amigabill/jhu_EN525.743/Docs/525.743_CDR_BillToner.odt

Critical Design Review (CDR)

Project Description

This project will design and implement a Smarthome lighting and ceiling fan control system. Controls will allow light fixtures to vary their brightness in a dimmable fashion, and ceiling fans driven by single-phase AC induction motors will be speed controllable.

Control messages will be sent wirelessly. The wireless communication will be using the Zigbee Mesh protocol. Xbee Series 2 modules will be used, in API mode and with built-in encryption capability enabled.

Wall “switch” controls will be small LCD touchscreens, communicating with the items they control via wireless command messaging. The LCD will allow the user to select a room, and then which target item in that room to view current status of, or to change it's state. (ie. The selected item in the selected room will get brighter, dimmer, slower, faster, etc.)

The target items being controlled will use a microcontroller as the Zigbee command receiver. Dimmable light fixtures or speed-controllable motor-driven target items will use a common Triac-based circuit to control the target as desired by the user.

A central computer server will log events, control “vacation mode” away events, and act as a gateway for automatic and manual controls sent from distant control devices carried by the home residents. This server will also act as the Zigbee wireless network “coordinator” node, in charge of the Zigbee mesh network. This server will also have an LCD touchscreen panel for

Android smartphones will offer both automatic and manual controls sent via the Linux server, and also a way to remotely view the server's log data in text form. Current status of the home targets will be visible in a GUI which mimics that seen on the LCD touchscreen wall “switches”. The mobile devices will primarily use a GPS based geofence to indicate whether the user is home or away. An alternative control method will be with the use of NFC tags at the front door of the home, so the user can manually swipe his or her mobile device across a tag to manually indicate that they are leaving or returning home. These two control capabilities allow the server to automatically enter and leave an automated, quasi-random “vacation mode”, where it will turn lights on and off at reasonable times to emulate the residents being home for added security from burglars.

This project will also be designed to allow future expansion, with possibility to add new kinds of target items to control and new types of controls. The intention is to complete a project comparable to popular X-10 systems, but which will send control commands wirelessly instead of signaling over power line. Some example ideas for future additions are garage doors, electronic entry door locks, thermostat HVAC environment control, or safety shutoff for electrics ovens or lab soldering stations, in case you forget to turn them off when you leave home, but these examples are not included in this semester's project effort.

While the ideal would be for the wall “switch” controls to fit into a standard Decora ™ wall-plate and housing gang area, and target controls would fit into common ceiling fan wiring canopies or other light fixture wiring boxes, this project during the semester will be made using prototyping computing and interface boards, which will not cleanly fit such common switch housing, and so will not implement a cosmetic ideal. To cosmetically fit into the popular housings would require custom PCB design and assembly to compact the various components used, as well as alternate choice of LCD touch panel of proper size, which may not be supported by the intended Arduino code libraries available, and require software porting to make use of. These additional tasks are beyond the scope of this semester's effort to create a working prototype.

This project evolved from an initial concept of a wireless controlled light switch, and complexity was added to bring that up to an acceptably complex project for this course.

This project is an individual effort, and does not depend on other projects, nor do other projects depend on this.

Functional Description

Diagram 1 shows the three types of user control units: 1) The wall-mounted LCD touchscreen controls, located in the building as any other type of light switch would be, and likely replacing older model switches as this system is installed, 2) The central Linux server and coordinator panel, which could be wall mounted or in an enclosure resting on a desk or table, and 3) The Android mobile device App. The possible communication participants are indicated with blue arrows to show a Zigbee connection, or green arrows to show an Internet connection.

Diagram 1:

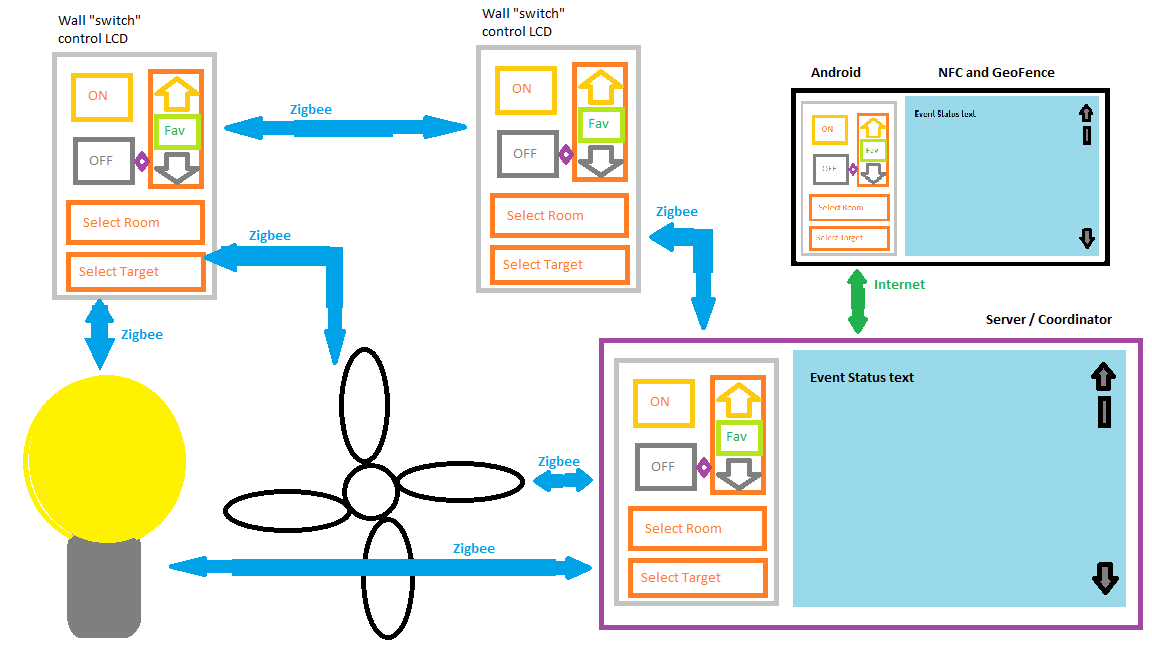
[picture p1: figure]

At boot time, any Arduino based node (either Uno or Due), will first check if a hardware push-button is asserted, to indicate that the user wants to use a PC on the board's USB port to configure the Xbee module, using the XCTU utility software. If asserted, then the Arduino board will enter a non-active microcontroller state to avoid contention on the USB pins. Otherwise, the board will continue to boot into operational mode.

An Arduino target node (controlling some load such as a light fixture or a ceiling fan, and potentially more than one load) will look to stored values in EEPROM or Flash to determine the last running intensity value for the load. Each load will then be set to be at that last saved intensity value. This will allow a quick recovery from a power outage, without a delay of waiting for the Linux server to boot, all the other Arduino nodes to boot, and receive, load ID by load ID, setting commands from the server based on the most recent settings found in the event log.

Once the last saved intensity value is restored to each load, then the target node microcontroller will begin listening for command messages from the Zigbee network.

A wall control Arduino node will proceed from the Xbee config check to gather information about controllable load units, which target nodes they are controlled by, room locations of loads, and what the “default” load ID and location are assigned to it.

Then, the wall control will begin polling the load IDs to learn their current intensity level or other status value.

The wall control then updates the LCD display to indicate the default load ID, location, and current intensity setting.

After the LCD is displaying the current situation for it's default load, the wall control unit will then begin listening for commands from the Zigbee network as well as from the touchscreen and any debug controls.

When a manual, debug or Zigbee control is received, any Zigbee node will carry out the messaging conversation as defined for that command type, and when completed will return to a state of waiting for another control input or message.

The Linux server will boot up, prepare Zigbee networking, prepare Internet networking, open the even log file for appending, read last known status for each node from event log, check what other nodes are expected to exist and check they are all booted and available with a Read Intensity command via Zigbee, note any nodes not responding, log any updated current values from the target nodes if not matching the last known value in the event log, determine the default load to display on the LCD and to control, configure the LCD display to show the now current intensity level for the default load ID, read and then display the event log text data. Then begin listening for Zigbee commands, listening for commands from the Internet, as well as waiting for touchscreen inputs.

The Android app will determine the related default load ID, prepare Internet networking, and attempt to connect to the Linux server via Internet.

If not successful in connecting to Linux Server, then draw to LCD an indication that connection is not available. Continue attempting connection periodically.

When successfully connected to Linux server, then get the now current states for target nodes, get the current event log content, draw the control panel indicating the current level for the default load as well as the default portion of the event log text data. Then wait for Android touchscreen input from user, and also periodically update node states and event log data from server.

If server becomes disconnected, then display an indication to LCD.

If server becomes reconnected, then update the indication to LCD.

Protocol

This system will use a Zigbee wireless method to communicate with other nodes. The message content will be encrypted by the Xbee module firmware, so our software will not need to include an encryption library.

The communication protocol will be a command made in 4 steps:

1. Sender sends command to recipient
2. Recipient Acknowledges command received, asks sender for confirmation
3. Sender sends confirmation
4. Recipient indicates completion success or failure

Diagram 2 shows the Arduino and shield configuration for an LCD touchscreen wall control node.

Diagram 2:

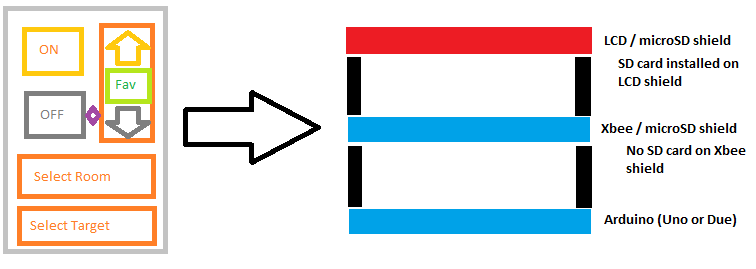
[picture p2: figure]

Diagram 3 shows the Arduino and shield configuration for a target node. This is identical for a light controlling node, a ceiling fan controlling node, and possibly some other node types which could be added in the future. One target node can actually control two, or possibly a few more than that, loads, so that one unit can control both a light and a fan.

Diagram 3:

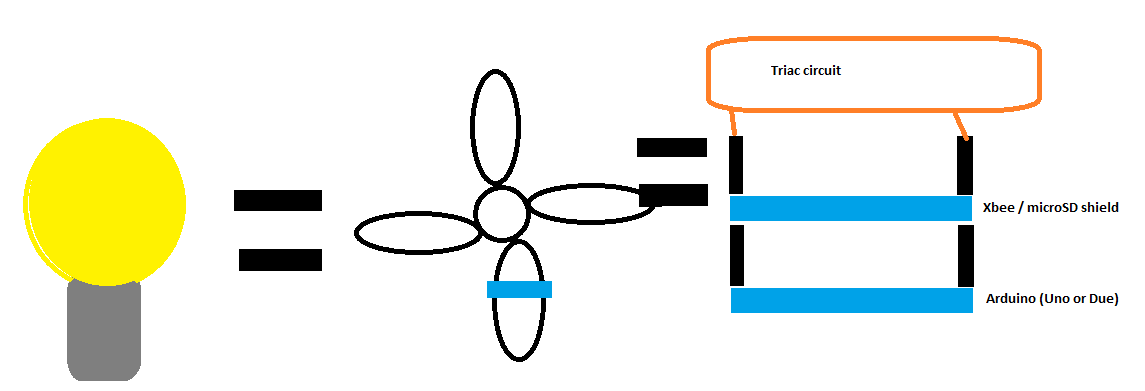
[picture p3: figure]

Interface Description

The most commonly used interface will be a small LCD touchscreen, mounted about the home (or business) in wall-switch wall-plate locations.

The LCD will display

- A Graphical User Interface to select the room and target device location, view current target state (as the target may be located in another room and not directly visible)
- Control buttons to increase or decrease target brightness or speed, full on or off, or some favorite intensity level for that target. An indicator will move up and down in a small track to indicate the currently set intensity.

The Linux Server and the Android app will display the same control panel as described in Diagram 1 for the wall controls, but adds visibility of the event logging data as well. This keeps things consistent and familiar, so that the user only needs to learn to use one control interface arrangement. It would be confusing and irritating if each control type looked significantly different from the others. The only variance will be the omission of event log visibility on the small wall switch controls.

Diagram 4 shows the pin mapping of the two types of Arduino microcontroller boards and the different “shield” boards I plan to connect to the Arduinos. This diagram shows that the LCD touchscreen wall “switch” nodes have a conflict on pin 4 between the LCD shield and the Wireless/SD shield. This is not a significant problem, as for these nodes, I will instead use the SD slot located on the LCD shield to avoid any conflicts. Target nodes will not include the LCD shield, and so there is no conflict on pin 4.

Diagram 4:

Table 1 describes the additionally required signals in and out of the Arduino units, which are required to interface to the 120V AC loads and to debug pushbuttons and LED indicators.

Table 1:

Description of Misc and Triac Signals
Signal Name | Description
Xbee config (also btn fn/lt sel??) | Active-Low – When asserted at boot time, Arduino goes into a dummy loop or does an exit, so that USB can be used to the Wireless/SD shield's Xbee module for configuration using XCTU software on a PC. Otherwise has no function. (might optimize to share this input with btn fn/lt sel, which is only effective in run-time)
Xbee config status | When lit, indicates that the Arduino board is in an inactive state so that a PC computer can communicate with Xbee module over USB for configuration, usign XCTU utility software.
btn fn/lt sel | When High (default by pullup), tells Arduino to apply any other manual button inputs to the Light control. When Low, tells Arduino to apply any other manual button inputs to the Fan control. (Also used on wall control node development to test communication and control of target, before adding LCD touch shield support. Once LCD shield is added, this button must be removed from wall control.)
btn On/Off | Active-Low – When asserted, change the target power applied state. Like a “bang-bang” power enable control. (Also used on wall control node development to test communication and control of target, before adding LCD touch shield support. Once LCD shield is added, this button must be removed from wall control.)
btn Up | Active-Low – When asserted, increase intensity (brighter/faster) to target. (Also used on wall control node development to test communication and control of target, before adding LCD touch shield support. Once LCD shield is added, this button must be removed from wall control.)
btn Down | Active-Low – When asserted, decrease (dimmer/slower) to target. (Also used on wall control node development to test communication and control of target, before adding LCD touch shield support. Once LCD shield is added, this button must be removed from wall control.)
PWM Light | Pulse-Width Modulated control of triac circuit for the Light target
PWM FAN | Pulse-Width Modulated control of triac circuit for the Fan target
AC 0-cross | Active-High - Input pulse to indicate the 120V AC line waveform has crossed the 0V line, and a new waveform period begins.

Zigbee message format

Each Zigbee message will have a twelve byte logical payload, as described below. The “physical” payload, in the Zigbee total frame, may be a few bytes larger, as I understand that the Xbee firmware encryption feature requires this to be done.

Each node will have one or more 16bit ID values, which will be the first two bytes in the Zigbee message payload. The first byte in the payload is the ID MSByte, and the second byte is the ID LSByte. Each node can potentially have more than one target load ID, such as a node that controls both a light and a fan motor. One load ID will relate to the light, and another load ID will relate to the fan. So there are multiple kinds of IDs that will be included in the total Zigbee frame, the Zigbee address ID, which is not part of the payload, and the target load ID, which is part of the payload. While a 16bit value may sound excessive to ID a particular load, consider that a commercial building could potentially consume more than the 256 ID values, if I had chosen a single byte ID. An individual home would not likely consume 256 IDs, even if every outlet, light switch and light bulb in the house was uniquely addressable. But I'd like this to have potential beyond the home market, and make it appealing to businesses as well.

The third and fourth bytes will be the MSByte and the LSByte, respectively, of the node sending the command. This will tell the recipient where to send response stages of a full command conversation.

The fifth byte in the payload indicates the current message type within a single multi-message communication. Such as this indicates the initial command request, or the acknowledgment/confirmation request, or the confirmation, or the command completion and status notice.

The sixth byte in the Zigbee message payload will be a command code. There will be several commands that can be made to the recipient. They will be encoded as a byte value for convenience in the case of Arduino Uno, which is an 8bit microcontroller with small memory resources. To help keep the stack and code compact, I will not choose to subdivide a byte into multiple different fields and then add code to mask and shift these fields around. This command code should remain fixed through all message stages of a single command communication.

Command | 8bit Encoding | Description
No Operation (nop) | 0x00 | Tell recipient to acknowledge and complete this communication, but otherwise do nothing.
On | 0x01 | Tell target to power on the load
Off | 0x02 | Tell target to power off the load
Increase Intensity | 0x03 | Set load to be one step brighter/faster
Decrease Intensity | 0x04 | Make light one step dimmer/slower
Set to Favorite level | 0x05 | Set target load to stored favorite level
Store current level as Favorite | 0x06 | Save current intensity level as Favorite
Read Favorite level | 0x07 | Ask target to say what the stored Favorite intensity level is
Read current level | 0x08 | Ask target to say what the current intensity level is
Event Notice | 0xFF | Inform the Linux server that a command event has been completed, and what the new status is, for log purposes. Inform the server what the command was, what the target load ID was, and the status value.

The seventh and eighth bytes will be the MSByte and LSByte, respectively, for any message passing a status value, a Favorite or current level read response, or event update notice.

The ninth byte will be the status value or the intensity level value asked for.

The tenth byte will be a CRC check on the first seven bytes of the payload.

The eleventh and twelfth bytes are reserved for future use.

Material/Resource Requirements

There are no dependencies from other projects. This project does not provide any dependencies to other projects. It is a completely independent effort.

This project is an individual effort. So there is no particular assignment of certain tasks between multiple team members, all project tasks are assigned to this single individual, Bill Toner.

There are three major components of the smarthome system. There are also some general household items, such as light fixtures, ceiling fan units, wiring boxes and power cabling which will be required.

Both the controls and the targets in the Arduino class will require an Arduino microcontroller board and the Wireless/SD shield, which holds an Xbee module and possibly a microSD card. The controls will also require an LCD touchscreen/SD shield, and the targets will also require the triac based AC line control circuitry. The target end will also require a couple lights and a ceiling fan to control. An Xbee module will be required for each Arduino and target node. A 2.4inch LCD touchscreen+SD module was chosen so that these prototypes are close to a standard Lenovo Decora™ wall-plate slot. A commercial product would need to refine into a more exact LCD package.

I have not yet purchased components for the triac AC line control circuits, as I will need more time to evaluate available app notes and examples to determine appropriate part numbers to use in this design. I will do this during the weeks leading up to my scheduled time to work on this part of the system, leaving a week or so for shipment and delivery. If delivery is for some reason delayed a little, then I will begin assembly of the Fan and light fixtures with some wiring and electronics enclosures in preparation of the triac circuits coming, and then begin work on the Android app until the AC control components are received.

I already have a couple Arduino Uno boards, have ordered one each of a few items for fast delivery, and ordered additional copies of some items at lower cost with slower delivery. I have now received Wireless+SD shield and LCD touch/SD shield. I also have ordered a few Arduino Due boards, and already have one in possession. Additional Unos and Dues are in shipment from Ebay sellers located in China. I have already received some items from Chinese sellers, and anticipate the remainder of my orders arriving by the end of the first week in October, 2015.

The Linux server will be built using an AMD Gizmo embedded computing board, a 7 inch LCD touchscreen, a USB WiFi dongle, an Msata storage card, and some custom connectivity to the Xbee module. I already have the Gizmo kit. I had purchased a Gizmo kit a few months ago in order to get an AMD jtag probe for unrelated personal interest. I will likely need to do some bread-boarding

For the Android class, I will be using the smartphones that My wife and I already own and use. I will also use a home Wifi network router that I already own as the backbone of my simulated internet between the Android devices and the Linux server.

I have acquired a couple simple, inexpensive light fixtures, wall electrical boxes, and an inexpensive ceiling fan unit, to act as my targets to be controlled by this system. If this fan unit, the least expensive one I could find amongst my local hardware stores, proves unsuitable, I do have another ceiling fan unit of higher quality pending a small home improvement project, which could be used as a backup in this project. I don't expect this to be necessary as there are several online examples and app notes in general agreement for how to use triacs to control ceiling fan motors. While a few discussions indicate that a capacitor and/or frequency based speed control circuit may be more ideal, I have not found any app notes or examples for this approach, but I will keep it in mind as an alternative should I have significant problems with the triac design. I will initially focus on the triac concept due to apparent popularity.

I plan to assemble the triac circuit I will use in an Ltspice simulation. Then, once satisfied with function and performance, I will use a suitable oscilloscope to observe the AC waveform applied to the initial test load, by a prototype hardware setup with an inexpensive incandescent light bulb. This will start out as an Arduino Uno being hard-coded for speed and/or being controlled by a PC laptop. I also have a commercial wired style light dim and fan speed control pending a home improvement project, which I can observe with a scope to learn behavior if I have problems with triac and need some ideas.

Table 2 shows various components required, how many of each, and the price. An estimated total cost is then shown as a sum of these items. The software development environments and the Linux operating system are all available free of charge, and without an expiration date.

Table 2:

Component | Needed | Already Have | Price Each | Total | Description
Arduino Uno | 3 | 3 | $3.67 | $11 | Microcontroller in direct control of target load units. Cheap clones from Ebay.
LCD Touchscreen/SD shield | 3 | 0 | $4.60 | $13.80 | For wall “switch” control nodes.
Arduino Due | 3 | 0 | $15.39 | $46.17 | Microcontroller for wall “switch” LCD touchscreen controls
Wireless/SD shield | 6 | 0 | | | For ALL Arduino nodes
2GB microSD cards | 6 | 0 | $2 | $12 | “Mass” storage for graphics, system node configuration, room locations, etc.
AMD Gizmo embedded computing board | 1 | 2 | $200 | | Linux server
Light fixture | 2 | 0 | $5 | $10 | Simple and cheap
Ceiling Fan | 1 | 0 | $32 | $32 | Cheapest at local store
Android mobile device | 2 | 2 | | | My wife and I already have Android smartphones. One supports NFC feature, the other does not. Both support GPS and Internet data networking.
Zigbee module in Xbee format | 7 | 0 | $26 | $182 | Wireless networking module for Arduinos etc.
Total | | | | $307 | approximate

Development Plan

The source code, circuit diagrams, documentation, and any other digital data related to this project will be committed and tracked using a Design Management (or Configuration Management in some vocabularies) repository using the GitHub service, located at the link below. This is set as a private repository, and I'll add professor and class members who may be interested, on request, and once I figure out how to do that.

https://github.com/amigabill/jhu_EN525.743

I plan to work on the various system components in the following order:

1. Arduino
- SD card storage (contains some node configuration data)
- Zigbee communication (With PC laptop as coordinator at this point)
- Target control of AC line triacs (with at least some visible output indication, such as a small LED, in place of final triac circuit)
- Touchscreen input events, using some pre-planned location for test “buttons”
- LCD GUI implementation
- Anticipating the possibility that the available libraries I plan to use may not all fit together into an Arduino Uno memory space, I plan to use Due boards for the LCD touch control nodes. Uno's are likely to be suitable for the target nodes, as those do not require LCD graphics related libraries or touch drivers, and will have a smaller memory footprint.
2. Linux Server (AMD Gizmo embedded project board)
- Zigbee coordinator
- Communicate with targets
- Communicate with wall touchscreens
- Implement event logging
- GUI using WxWidgets library
- Networking with internet, using a home WiFi router to emulate the internet. (Overlaps with Android App communicating with Linux server)
3. Android smartphone app
- Communicate with Linux Server
- GUI indication of targets current states
- GUI manual control of targets
- NFC tag manual location indications (easier to demo than Geofence)
- GPS Geofence locations (somewhat harder to demo than NFC)

The anticipated schedule is shown in Table 3.

Table 3:

There are 5 major milestones.

1. Arduino Uno target controller
2. Arduino Due wall-plate LCD touchscreen controller
3. Linux Server/Coordinator
4. AC line load controller circuit, which is controlled by #1 above.
5. Android Smartphone Application

It's important to start with the Arduino targets and controls, as without them there is nothing for a Linux server or Android app to do. The next major priority is the Linux based server, to coordinate the other Zigbee nodes, observe and control target events, etc. This server along with the Arduino nodes then make up the bulk of this project's core functionality. Once the server is complete, then I will implement the triac circuitry to control the AC line to a real target light or fan motor in place of the earlier placeholder status LED. At this point, within the home is a fully functioning system with “real” targets working. Finally, I will move on to implementing the Android app. Should scheduling slip, the Android app is not as critical as the Arduino nodes or Linux server roles in this project, and so if anything should not get completed, this app is the most reasonable choice to be worked on last.

Some modifications may be required to the shields to improve signal quality on Arduino pins used on both modules, such as D4 which is SD_CS on the Xbee/SD shield, and an LCD data pin on the LCD shield. Cutting the D4 and other SD slot traces on the Xbee/SD shield, and not using SD on the Xbee/SD shield can help. The LCD shield has another microSD slot on it, using D10 for SD_CS instead of D4.

There are some risks in this schedule.

- I have not worked with Arduino or AVR microcontrollers before. During my previous experience with Atmel Sam-4 ARM devices, I worked some with SD protocol, in both C and Verilog, which would be beneficial to this project. I also worked with other peripherals such as Usart and Duart, parallel ports, interrupts, and I also had experience programming the Rabbit3000 and Xilinx Microblaze in prior courses at Johns Hopkins University, to show that I can move to different library APIs/ABIs in an acceptable time-frame for comparably complex projects.
- I have not worked with wxWidgets for a GUI application in Linux before. There are Rapid Application Development tools available, which I will make use of to assist in building the general code framework and creating the GUI interface. There is a thriving online support community for wxWidgets, and I have been looking at the API a little while pondering an unrelated project to port the wxWidgets framework to an operating system it is not currently available for, so I'm not going into that with a completely clean slate.
- I have a small amount of experience with internet networking, such as the communication between Android app and Linux server. This experience is from the JHU course EN.525.742 System on Chip FPGA Design Lab, which I took a couple years ago. There I learned about ethernet message packets using Xilinx Microblaze microcontroller and a minimal library to hit the hardware, and the use of WireShark for debugging packets coming out of the FPGA board. I will be sending simpler messages in this project.
- How to demo geofence within range of WiFi router in the classroom? I will see if I can bribe my wife into being a remote participant during demo night, using her Android device over cell data network communicating with the Linux server via the WiFi hotspot in my own Android device, which will act as my in-classroom “home internet router” for the Linux server.
- I have not programmed in Java before. I plan to use a Rapid Application Development tool to assist with general code framework and creating the GUI interface. From there, I will have to be able to take a general pseudo code of my intended application and quickly learn the Java syntax to accomplish that design. Online Java examples abound, and there are several online support communities available when I have a question.
- During week 5, after the PDR presentation, my supervisor at work has asked me to attend a week-long training seminar in the month of November, along with everyone else in the group under him. It will be difficult to keep up with my normal work, the training, evening group meetings and other activities, and also continue a good pace on this project. I have requested permission to take a few days vacation to focus on this project to compensate, and also described the situation regarding this course and scheduling, and await a reply to this request. I rarely take time off work, I now have a second person assisting in my role, and my overlords have a history of being very supportive of the time off requests that I have made in the past, so I do not anticipate that this training event will have a significant impact on this project schedule.

References

The programming environments, operating systems, and support libraries that I plan to use are all available at no cost. There are no expensive licenses to buy or to expire at an inconvenient time.

Programming IDEs, SDKs, and Frameworks:

- Arduino - https://www.arduino.cc/en/Main/Software
- Android Studio/SDK for Java - https://developer.android.com/sdk/index.html
- Android NDK for C/C++ - https://developer.android.com/ndk/index.html
- Linux for AMD Gizmo board - http://www.timesys.com/register/gizmo
- wxWidgets (for Linux GUI in C++) - http://wxwidgets.org/

I plan to make use of available libraries as much as possible for various components of the software.

Arduino Libraries:

- Arduino SD library - https://www.arduino.cc/en/Reference/SD
- Arduino TFT Library for LCD panel driver, or relevant equivalent for the LCD controller used - https://www.arduino.cc/en/Reference/TFTLibrary
- Yamsam LCD https://github.com/yamsam/TFTLCD_ST7781

Arduino Shield documentation:

- Xbee+microSD - https://www.arduino.cc/en/Main/ArduinoWirelessShield
- LCD touch+microSD
- http://www.smokeandwires.co.nz/blog/a-2-4-tft-touchscreen-shield-for-arduino/ (for same LCD controller info and library)
- https://github.com/yamsam/TFTLCD_ST7781
- SmokeandWires LCD http://www.smokeandwires.co.nz/blog/a-2-4-tft-touchscreen-shield-for-arduino/
- Adafruit Graphics Core library - https://learn.adafruit.com/adafruit-gfx-graphics-library/overview

Digi Xbee

- http://ftp1.digi.com/support/documentation/90000976_W.pdf
- http://knowledge.digi.com/articles/Knowledge_Base_Article/What-is-API-Application-Programming-Interface-Mode-and-how-does-it-work
- https://github.com/andrewrapp/xbee-arduino
- http://ftp1.digi.com/support/utilities/digi_apiframes2.htm
- http://arduino.stackexchange.com/questions/1500/how-to-make-xbee-module-interrupt-wake-arduino

(http://wxwidgets.org/)

Ltspice

- http://electronicdesign.com/power/model-diacs-and-triacs-ac-line-control
- http://electronics.stackexchange.com/questions/87546/ltspice-mac97a8-triac-model-vgs-error

There are several online app notes and example designs which will be relevant to this project:

- Atmel AVR datasheet (Arduino Uno) - http://www.atmel.com/Images/doc8161.pdf
- Atmel SAM3 Cortex-M3 datasheet (Arduino Due) - http://www.atmel.com/Images/Atmel-11057-32-bit-Cortex-M3-Microcontroller-SAM3X-SAM3A_Datasheet.pdf
- Triac AC line control:
- Microcontrollers: From Assembly Language to C Using the PIC24 Family http://www.freescale.com/files/microcontrollers/doc/ref_manual/DRM039.pdf
- http://cache.freescale.com/files/microcontrollers/doc/app_note/AN3471.pdf
- http://www.st.com/web/en/resource/technical/document/application_note/CD00003820.pdf
- http://ww1.microchip.com/downloads/en/AppNotes/91094A.pdf
- http://www.mouser.com/catalog/specsheets/stevalill004v1.pdf
- https://books.google.com/books?id=ndALAAAAQBAJ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

LCD touchscreen for Linux Server

- http://www.sainsmart.com/7-inch-tft-lcd-monitor-for-raspberry-pi-touch-screen-driver-board-hdmi-vga-2av.html

525.743 Fall 2015 Critical Design Review (CDR) Johns Hopkins University Bill Toner Smarthome Lighting and Fan Control
