amigabill/jhu_EN525.743/Docs/ZigbeeNotes.odt

All radios in same network must have same PAN ID set.

AT Mode

- Needs DH and DL set to assign the destination radio, using atdh and atdl commands
- Broadcast destination address, in DH and DL settings, 0x00000000, 0x0000ffff is broadcast to all radios in same PAN ID
- Specific destination address, in DH and DL settings, goes only to that one receiver.

API Mode

- Does NOT need DH and DL set to assign destination radio. This is done within the API frame.
- Broadcast destination address, in the API frame, 0x00000000, 0x0000ffff is broadcast to all radios in same PAN ID
- Specific destination address, in the API frame, goes only to that one receiver.
- Data to send goes into uart TX buffer via Serial.write(), API frame type is 0x10
- Received data in uart RX buffer via Serial.read(), API frame type is 0x90 RX Received

Mixed API and AT modes

- An API mode module can talk to an AT mode module, and vice-versa
- The API or AT mode is how the thing on the serial port (microcontroller, PC etc) talks to the module.
- The choice between API and AT has no effect on how radios talk to other radios.

Sending data

- API frame type is 0x10, Transmit Request
- API mode sender puts full frame data into uart TX buffer, from delimiter to checksum, inclusive.
- AT mode sender puts ONLY the payload into uart TX buffer.
- It doesn't matter what mode the receiver isin.

Receiving data

- It doesn't matter what mode the sender was in.
- API receiver receives the full frame at uart RX buffer, from delimiter to checksum, inclusive.
- API frame type is 0x90, RX Received
- AT receiver receives ONLY the payload on the uart RX buffer.
