amigabill/jhu_EN525.743/Docs/pdr_wtoner_2015fall2_as_submitted.pptx

## Bill’s Automated Home System

Arduino, Linux and Android system for wireless control of home lighting and ceiling fans.

## Wireless Smarthome System

- Will use Xbee type Zigbee modules for wireless communications, in a Mesh configuration.
- Arduino prototyping boards for “wall switch” controls and target receivers. Arduinos will be Zigbee router endpoints.
- Linux based central “server” and Zigbee Coordinator. Coordinates Zigbee network, logs activity,, controls away/vacation events, provides control and status capability via internet.
- Android smartphone control. (I don’t’ have an Apple iDevice, but that could be some future addition)

## Zigbee wireless

- Mesh topology.
  - Central “Coordinator” running Linux, connected to an Xbee coordinator module
  - Using routers (as endpoints) in the Wireless topology helps to extend communication range if there are radio obstacles in some parts of the home, or if certain locations are at a long enough distance for weak signal at low broadcast power levels. Run by home AC mains, so no real worries about power consumption to require true endpoints.
  - Arduino controls use Xbee router node
  - Arduino target receivers use Xbee router node
  - Use Xbee modules in API messaging mode
  - Encryption for Security – Xbee’s APS mode or Arduino AES software library

## Controls

- LCD touchscreen “wall switch” – 2.4inch model is inexpensive for Arduino. Depending on code size, either Uno or Due microcontroller.
- LCD touchscreen server/coordinator. Logging and controls also accessible via internet/WiFi Android device. Programming/controls access via SSH to PC. Either an AMD Gizmo (I want to use it for something) or Raspberry Pi would make a decent central coordinator.
- Android Geofence (GPS location of family smartphones)
- Android manual control App
- Android NFC tags by front door as option to geofence

## Controllable Targets

- Light fixtures - Dimmable fixture – using a Triac based circuit
- Ceiling Fan - Single-Phase AC Induction Motor – also use Triac based circuit
- On/Off for simple light fixtures, outlet dongles, small appliances, etc.
For dim/speed control, detect a zero-crossing of the AC Line waveform, and then pulse the Triac for some percentage of the AC line waveform. Adjust the amount of the AC Waveform time the Triac is on to control dim/speed.

## LCD Touchscreen Controls

- Select Room
- Select Target (light, fan, desk lamp etc)
- Darker/slower
- Lighter/faster
- Store (in target?) current setting as favorite (to eeprom, flash or SD)
- Go to favorite level/speed (from whatever current state)
- Communicate to selected target
- Communicate to server for logging
- Receive from Server for other controls (smartphone or server panel) to update local target state changed by another control.
- Full on or off (also available in a simpler button or toggle switch control dedicated to a particular target set)

## Control Message via Zigbee

- Command, Acknowledge, Confirm, Completed. (master, slave)
- Network ID (not same as plaintext Zigbee ID)
- 16bit node ID (not same as plaintext Zigbee ID)
- Node type (touchscreen control, toggle control, dimmable light, fan, server, etc)
- command (on, off, dimmer, brighter, slower, faster, status update, store favorite, ask favorite, ask current, No-OP, Update ID, Config Node, Add Node, etc)
- current dim/speed level
- a security handshake code
- 16bit Old ID, 16bit new ID (for an ID update)
- Add node command includes new node ID, it’s type, current state, room location, so that controls will know about it
- Add room location includes room ID
- All message content encrypted, don’t use any non-encrypted Zigbee framing info in determining what to (or not)
