amigabill/jhu_EN525.743/user_smarthome/.wxSmartHome/IMAGES/BCKDRP2.BMP

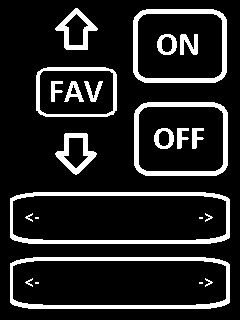
user_smarthome/.wxSmartHome/IMAGES/BCKDRP2.BMP
