amigabill/jhu_EN525.743/user_smarthome/.wxSmartHome/IMAGES/BCKDRP24_short.BMP

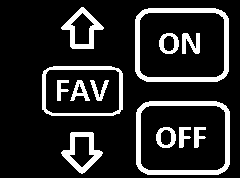
user_smarthome/.wxSmartHome/IMAGES/BCKDRP24_short.BMP
