amigabill/jhu_EN525.743/linux/wxSmartHomeServer/shLinuxSerialPort.h

#ifndef SH_LINUX_SERIAL_PORT
#define SH_LINUX_SERIAL_PORT

/***************************************************************
 * Name:      shLinuxSerialPort.h
 * Purpose:   Defines Serial port access class for project Linux "gateway" node
 *            I initially planned to use Boost-Asio as a foundation,
 *            but had problems getting that working. It's now based on file descriptors,
 *            but I would like to get back to a boost-asio implementation later,
 *            and get away form dependence on Linux style file descriptor style access.
 *
 *            Inspired by references and examples at
 *            http://linux.about.com/od/commands/l/blcmdl1_stty.htm
 *            http://www.cmrr.umn.edu/~strupp/serial.html
 *
 *         // did not end up using Boost-Asio, but keep examples here for future reference
 *         // ignore boost comments for now
 *         // This file provides a simpler serial port API for Linux, making
 *         // of Boost::asio calls.
 *         // This will encapsulate many details of configuring serial port
 *         // for the SmartHome Xbee/Zigbee module running at 9600 8N1
 *         // Use async_read into a single-byte buffer to avoid blocking on
 *         // a serial read which may not happen for a long time.
 *         //
 *         // Based on examples at
 *         // http://www.cmrr.umn.edu/~strupp/serial.html#5_1
 *
 * Author:    Bill Toner (wtoner1@jhu.edu)
 * Created:   2015-11-17
 * Copyright: Bill Toner (2015)
 * License:   This library is free software; you can redistribute it and/or
 *            modify it under the terms of the GNU Lesser General Public
 *            License as published by the Free Software Foundation; either
 *            version 2.1 of the License, or (at your option) any later version.
 *            http://www.gnu.org/licenses/old-licenses/lgpl-2.1.en.html
 * **************************************************************/


#include <wx/string.h>
#include <wx/file.h>

#include <stdint.h>
#include <stdio.h>
#include <sys/stat.h>
#include <fcntl.h>



#include "SmartHomeServerAppDetails.h"

#include "SmartHome_Zigbee_defs.h"

// Boost-Asio library was experimental early on, and not yet fully implemented here.
// Kept around for future reference/attempt
//#define SERVER_USING_BOOST_ASIO_SERIALPORT
#ifdef SERVER_USING_BOOST_ASIO_SERIALPORT
// Boost Asio library for communications things, such as serial port for Zigbee
//#include <boost/asio.hpp>
//#define SH_SERVER_SERIAL_PORT_NAME  (std::string)"/dev/ttyUSB0"
#define SH_SERVER_SERIAL_PORT_NAME  "/dev/ttyUSB0"
//const char* SH_SERVER_SERIAL_PORT_NAME = "/dev/ttyUSB0";
#define SH_SERVER_SERIAL_BAUD_RATE  9600
#define SH_SERVER_SERIAL_CHAR_SIZE  8
#define SH_SERVER_SERIAL_STOP_BITS  boost::asio::serial_port_base::stop_bits::one
#define SH_SERVER_SERIAL_PARITY     boost::asio::serial_port_base::parity::none
#define SH_SERVER_SERIAL_FLOW_CTRL  boost::asio::serial_port_base::flow_control::none
#endif

class shSerialPort
{
    public:
        uint8_t ZBfrmReadyTX = 0; // a Zigbee frame is ready to transmit
        uint8_t ZBfrmReadyRX = 0; // a Zigbee frame has been received

        int shSerialPortFD = 0;

        // constructor
         shSerialPort(void);

        // destructor
        ~shSerialPort();

        bool start(const char* portName, unsigned int baud_rate);

        // stop the serial port and close it out
        void stop(void);

        // say if rxBuffer contains a new Zigbee frame/SmartHome message
        bool rxAvailable(void);

        // read a byte
        uint16_t rxReceive(void);

        // transmit the content of
        uint8_t txSend(uint8_t charTX);


    private:
//        boost::asio::io_service _ioService;
//        boost::asio::serial_port _shSerial;
//        std::string  shSerialPortName[20];


        char         _shSerialPortName[40];
//        wxString         _shSerialPortName;

//        wxFile _shSerialPortZBwxFile();
//        int          _shSerialPortFD;
//        wxFile       _shSerialPortwxFile();

        uint8_t      _txBuffer[ZB_TX_FRM_BYTES];  // buffer to hold Zigbee frame/SmartHome message to send
        uint8_t      _rxBuffer[ZB_RX_FRM_BYTES];  // buffer to receive a Zigbee frame/Smarthome message into



        // callback function for boost library's async_read to call upon
        // we will do async_read with size of 1 byte, check that byte, and if a Zigbee delimiter char then read the
        // remainder of the Zigbee frame. If the first char is NOT a Zigbee delimiter, then ignore it.
//        void _async_read_callback(const boost::system::error_code& error, std::size_t bytes_transferred);

};

#endif // SH_LINUX_SERIAL_PORT
