amigabill/jhu_EN525.743/linux/wxSmartHomeServer/wxSmartHomeServerApp.h

/*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
 * Initially generated by wxSmith GUI builder tool
 **************************************************************/


#ifndef WXSMARTHOMESERVERAPP_H
#define WXSMARTHOMESERVERAPP_H

#include <wx/app.h>
#include <wx/file.h>
#include <wx/log.h>

#include <stdint.h>

#include "SmartHomeServerAppDetails.h"

#include "wxSmartHomeServerMain.h"

#include "SmartHome_Zigbee_Linux.h"

const char* SH_SERVER_SERIAL_PORT_NAME = "/dev/ttyUSB0";
const int   SH_SERVER_SERIAL_BAUD_RATE = 9600;


class wxSmartHomeServerApp : public wxApp
{
    public:
        virtual bool OnInit();
        void OnIdle(wxIdleEvent &event);

    private:
        uint8_t  _appIsReady = NO;
        wxSmartHomeServerFrame* Frame;
        size_t   _shLogFileNumLinesPrev = 0; // number of lines in the SmartHome Control Event log file from the last time we checked
        size_t   _shLogFileLengthPrev = 0;   // number of bytes in the SmartHome Control Event log file from the last time we checked
        wxString _shCurrentDateTime;
        wxString _shCurrentDay;
        wxString _shCurrentMonth;
        wxString _shCurrentDate;
        wxString _shCurrentYear;
        wxString _shCurrentFullDate;
        wxString _shCurrentDayFullDate;
        wxString _shCurrentTime;

//        SHzigbee mySHzigbee = SHzigbee();
        SHzigbee _mySHzigbee;


        bool _SHupdateGUIlogText(const wxString& shLogFileName);
        uint8_t _SHupdateGUItimeText(void);

        uint8_t _SHreceiveZBserialData(void);
        uint8_t _SHsendZBserialData(void);

        void _doServerNodeIDmsgSM(void);
        bool _logSHcmdEventIfCompleted(void);

        void _shGUIupdateLoadIntensityLevel(void);
        void _SHnewMsgUpdateLoadNodeInfo(void);


        DECLARE_EVENT_TABLE()

};

#endif // WXSMARTHOMESERVERAPP_H
