amigabill/jhu_EN525.743/(commit log)

2015-09-24 Added initial PDR doc, estimated schedule, some dir structure for different componentsof the overall system. Eclipse .project file.
    [schedule.xlsx]
2015-09-25 Initial pin-mapping spreadsheet to compare Uno, Due boards and Zigbee and LCD shield pin requirements. Initial early copy of CDR doc. Much work to be done.
    [Billduino_Pins.ods]
2015-09-27 Minor update to schedule to reorder itms and add Work travel week. Much added to CDR doc Some items added to PDR for items missing from presentation. Not fir resubmission, but for a better example la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
    [schedule.xlsx]
2015-09-28 Updating CDR with more details, updated schedule, list o fmilestones, block diagrams, Arduino pinouts, etc.
2015-09-28 Lots of additions to CDR. This is now the version to be submitted on Blackboard for grading. The pin diagram here needs to be merged back into the separate Billduino_Pins.ods file.
2015-10-12 Added many #defines, and a few structs for the Zigbee message frame and our SmartHome payload architecture. Am able to Receive a Zigbee frame, in format expected for this SmartHome system, and parse 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
2015-10-12 Some small binary files representing Zigbee frames, for convenient upload usage with PC/RealTerm, to transmit to Xbee/Arduino receivers
2015-10-12 I thought this file was already in git control, but I'm fumbling to get it to commit/push after some work. So did an Add to Index as well. Some cleanup of debug code for RX of Zigbee frame. Restructu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
2015-10-12 Transmit a TX Request message now works for Arduino Uno. Same does NOT work for Due at this point. Need to debug differences between the different CPUs.
2015-10-12 Add some document files, CDR iterations from different laptops that later got combined before I figured out this Git thing Spreadsheet of SZigbee IDs for the Xbee modules I have Some notes about how 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
    [zigbeeIDs.ods]
2015-10-12 unoNodeTarget.ino.ino (sorry about double-file extensions, I'm still getting used to Arduino IDE and didn't know it did that on top of my own typing to the extension) here is a direct copy of the inc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
2015-10-12 Give a more meaningful filename, as this source file doesn't do as the name suggests anymore.
    [uno_xbee_debug.ino]
2015-10-14 Converted variable types to uint8_t, uint16_t and uint32_t to help port into Due boards. Tested still works in Uno, not yet in Due. Rearranged a few things to improve readability and correctness in S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
    [unoNodeTarget.ino]
2015-10-22 Finaly figured out, kindof (works for one but not another), to use alibrary that is not isntalled into the Arduino IDE tool installation area, but nearby and in the overall SmartHome project area so 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
    The uniNodeTarget.ino has significant changes.
    EEPROM is now used to store node ID info, number of nodes in this
    microcontroller, etc.
    Xbee send message seems broken. Receive message still works. Receive
    uses the EEPROM data to know if message is for this node or not.
    Pin Change Interrupts are in use for AC line Zero-cross detection as
    well as manual pushbuttons for ea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
    [unoNodeTarget.ino]
2015-10-25 Add SDcard dir structure, currently including some BMP images for the wall switch LCD display. Will later also add dirs for rooms and files about their loads' IDs and types, and more BMP images.
    Add manual pushbuttons to the target controller node code. Now have two
    LEDs representing individually controllable nodes. Brightness is
    controllable via PWM at 60Hz. Close to moving these trigger callbacks
    over to the receive message/execute command section.
    AC ZeroCrossing detection framework in place, using trigger signal from
    a ZeroCross Tail unit form the PowerSwitchTail.com people.
    Have not tested output to AC relay, as I mistakenly ordered a
    PowerSwitch Tail II mechanical relay unit, but shou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
    [unoNodeTarget.ino]
2015-10-29 Renamed wallControl.ino to wallControl, as Arduino IDE implicitly adds .ino and makes it weird when I also do. Have initial touchscreen wall switch graphics displaying on an Arduino Mega 2560, gettin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
    [wallControl.ino]
2015-10-30 Zigbee TX REQ API frame transmit seems to finally be working. This portion should be spun out into separate library so that it can be shared with the Arduino target driver program as well, and perhap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
2015-10-31 Moved the working Zigbee TX REQ frame transmit code out of wallControl.ino and into a Cpp library, for sharing with the unoNodeTarget.ino etc. programs. This was tested to work as well as previous co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
2015-11-01 Previous commit seemed working OK, then I tried to redraw the level indicator bar and level bob graphics over the backdrop, and had problems. The bmpDraw function used from the stitftbitmap example p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
    I had a directory named SDcard to store graphics, templates, various
    node info files, etc. I've not renamed the generic directory t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
    [wallControl.ino]
2015-11-03 Adding logic for room and load change buttons. This will update the curent target load ID etc. info where command messages will be addressed to (such as On, Off, etc. buttons) and will draw the room 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
    [wallControl.ino]
2015-11-06 Improved on command messaging state machine. Added a hack to move directly from the CMD_REQ state to the COMPLETED state, and also call the do*SM function immediately in itself to achieve the COMPLET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
2015-11-06 Improved the FAV response so the LCD udpates as appropriate. It had previously gone to level 0 on the LCD level indicator, but the message it sent said level 4. Corrected.
    [wallControl.ino]
2015-11-06 Add check to avoid turnign on if already on or turning off if already off.
    [wallControl.ino]
2015-11-08 The Zero-Cross interrupt is working, and able to control light bulb dimmness via PowerSSR Tail unit. This is currently somewhat hard-coded for the dimness/brightness, and needs improved to be run-tim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
    Does not appear to be receiving Zigbee messages, need to investigate
    further.
2015-11-11 Moving the Zigbee Receive Frame code into the SmartHome_Zigbee library, out of the unoNodeTarget.ino file. Adjustments to WallControl.ino and the SH Zigbee library as the code moves.
2015-11-11 Some cleanup to get the WallControl.ino working again. I had tried to correct the ordering of src and dest IDs passed to SHzigbee::prepareTXmsg as some calls seemed to have that backwards. Had confus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
    [wallControl.ino]
2015-11-11 Corrected typo in Zigbee frame receive code. Had used a wrong define to index the SH message type, the index #define used was for StatusL offset, which led to odd behavior and wrong checksum calculat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
2015-11-12 Added directory trees for SDScard_01 and SDcard_02 which contain the files to be placed onto microSD cards for use in the wall control units (Arduino Mega 2650) A lot of Zigbee message code was remov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
2015-11-13 I'm suspecting problems in receiving Zigbee frames is a timing issue, that too much time is spent elsewhere for serial port to read data fast enough, and some bytes are lost to oblivion. Reworking th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
    [unoNodeTarget.ino]
2015-11-14 Refactoring the ZB frame receive code for simplicity and more atomic Serial.read() stuff. Previously, I tried to allow for other things to run between reading bytes. That worked in principal, but in 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
    Refactored unoNodeTarget.ino to a (CONST == variabl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
2015-11-14 Improvements to ZB frame receive code, additional debug. Added #define switches to enable/disable debug output, for the ZB xmit/receive things, to help save resources when not needed. I did this when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
    [unoNodeTarget.ino]
2015-11-20 added graphics
    Added some graphics to break the room and load name buttons into
    separate ections for hte wxWidgets server app
2015-11-23 Added SERVER.BIN file to SDcard_* direcotries. Only a server will read these, to get its SmartHome Node ID info The Linux server app using wxWidggets is benning to have a functional GUI. The "wall co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
    room and load buttons do NOT yet update with names, or update load info
    text log does NOT yet work/not implemented
    Zigbee does NOT yet work/not implemented
    ethernet/internet does NOT yet work/not implemented
2015-11-26 Added wxSmartHomeServer.depend and wxSmartomeServer.layout, but am not real whaerus ylt they are. Perhaps Code::Blocks config files for the project. I hadn' tnoticed them previously.
    For the *App and *Main files, have added a working function call during idle event to check the file size of the SmartHome event Log file and if that has changed then refresh the GUI text area. NOTE that the refresh does not currently first clear the text area as expceted, but new text is added automatically on the fly, as the log file changes transparently from an unrelated text editor task, so changes to file are detected and responded to.
2015-11-26 Now clear the GUI text area for log file content display when refreshing. Cleaned up the log file GUI display code, removing previous attempt (already commented out but not previously deleted) using 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
2015-11-30 Adding serial port code to the Linux Server app - initially tried using Boost-Asio library with much confusion - changing to using file decsriptors and stty/ioctl things instead of boost but not yet 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
    Arduino uno load driver code changing to use Timer1 irqs isntead of software wait loops. Th ewait loops take too much time for serial port data to be received correctly.
    [shLinuxSerialPort.cpp, shLinuxSerialPort.h, unoNodeTarget.ino, wallControl.ino, wxSmartHomeServerApp.cpp, wxSmartHomeServerMain.cpp, wxSmartHomeServerMain.h]
2015-12-01 Adding in function to get the current date/time and prepare that for display on the GUI, as well as for use in log file time-stamps
2015-12-02 Slightly rearranged GUI display of control buttons, to make room for date and time above them. GUI display of date and time working better. Still not seeing name of day for some reason. Changed GUI r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
2015-12-07 moving to timer1 irq for dimmer.speed control
    uno driver changed from software wait loops for timing, as those did not
    allow enough time to receive all serial data, to using Timer1 interrutps
    instead, to trigger triac control times for each dim/speed intensity
    level.
    Rearranging wallcontrol code a bit, improved "debouncing" etc.
2015-12-07 timerone lib fixed
    I'm not sure what the timerone library authors were thinking, bu tI
    couldn't get it to work for me. I changed to to fast PWM mode, removed a
    divide-by-two, and it works much better.
    Also adding wallcontrol file here, which was accidentally left out of
    previous checkin. As a reminder, this improves the touchscreen
    "debounce" and other code cleanup.
    [wallControl.ino]
2015-12-09 ON and OFF buttons in GUI are now sending Zigbee messages which are received in another terminal window on another computer. Can proceed with adding additional command messages, simular to the Arduin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
2015-12-11 Did a lot of code cleanup to remove commented out experiments Linux App is receiving and logging SmartHome command messages from serial port. This is currently an early-ish development and will log A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
2015-12-12 some minor cleanups Changed ROOM_NO_LOADS from 0xffff to 0 for debug, I had become confused by 65535 value, and 0 is easier to handle Simplified how to update Room and Load names in GUI display Load 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
2015-12-12 Added #defines for MAX number of rooms and loads, rather than use in-line hard-codes Room name now updates when change rooms with GUI buttons The SmartHome_Zigbee.h file looks like different text edi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
2015-12-13 SmartHome_Zigbee.h - I thought I committed this last time. Loooks like spacing changes due to different text editor, I don't notice any functional diff.
    Added check to only flag a message for logging if it is a command completed message type. Previously logged ANY incoming message for early development convenience.
    (AckReq and Confirm messages still not yet implemented)
    Corrected message logging - had control and load IDs reversed in the output text.
    The Linux current intensity guage is following the load now, rather than trying to draw that only based on local GUI button commands from user.
    [SmartHome_Zigbee_Linux.cpp, SmartHome_Zigbee_Linux.h, wxSmartHomeServerApp.cpp, wxSmartHomeServerApp.h]
2015-12-13 disable some debug output popup windows implement INC, DEC and FAV button messages intensity level guage now updated only when receive a command completed message from the currently selected load. (i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
2015-12-13 catch-up the unoNodeTarget.ino file
    load driver node now supports read command to send current level,
    favorite level, and isPowered state back to inquiring node
2015-12-13 wallcontrol Arduino now follows load level on LCD
    Even when some other controller changes the load intensity level, if it
    matches the currently selected load at this wall control unit then
    update the LCD levelindicator to match, so indicators are not out of
    sync with each other on different controls
    In the unoNodeTarget.ino file, delete some commented out code chunks
2015-12-13 wallControl arduino now asks load for intensity level
    the Arduino wall control units will now ask their selected load what
    intensity level to indicate on LCD. This is done such as when changing
    which load is selected to control, in case some other control has
    changed it since we last selected this load.
2015-12-15 Add the dir tree for .wxSmartHome/ which should be found inside of /home/smarthome/ area. This includes node data files the Linux gateway needs to communicate with loads and to track what other contr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
2015-12-16 Updated Documentation
    changed "server" to "gateway" in most instances, as the Linux node isn't
    really "serving" anything. It has potential to become more of a gateway
    or hub between different connection transport types, such as to bridge
    form internet/wifi to Zigbee. project doc is polished up a bit,
    correcting some things that are no longer valid, added what license the
    3rd party libraries/drivers use, added C++ struct for the SmartHome
    message and the NodeInfo datasets.
2015-12-16 added Assembly and Performance sections to doc
    update documenttaion with missing sections
