amigabill/jhu_EN525.743/(notices)

Notices in the files:
arduino/SmartHomeProject/unoNodeTarget/unoNodeTarget.ino:
License: This program is free software; you can redistribute it and/or
